danwahl/well-siting-meter/well-siting-meter.brd

## EAGLE design well-siting-meter.brd (2018-08-06)

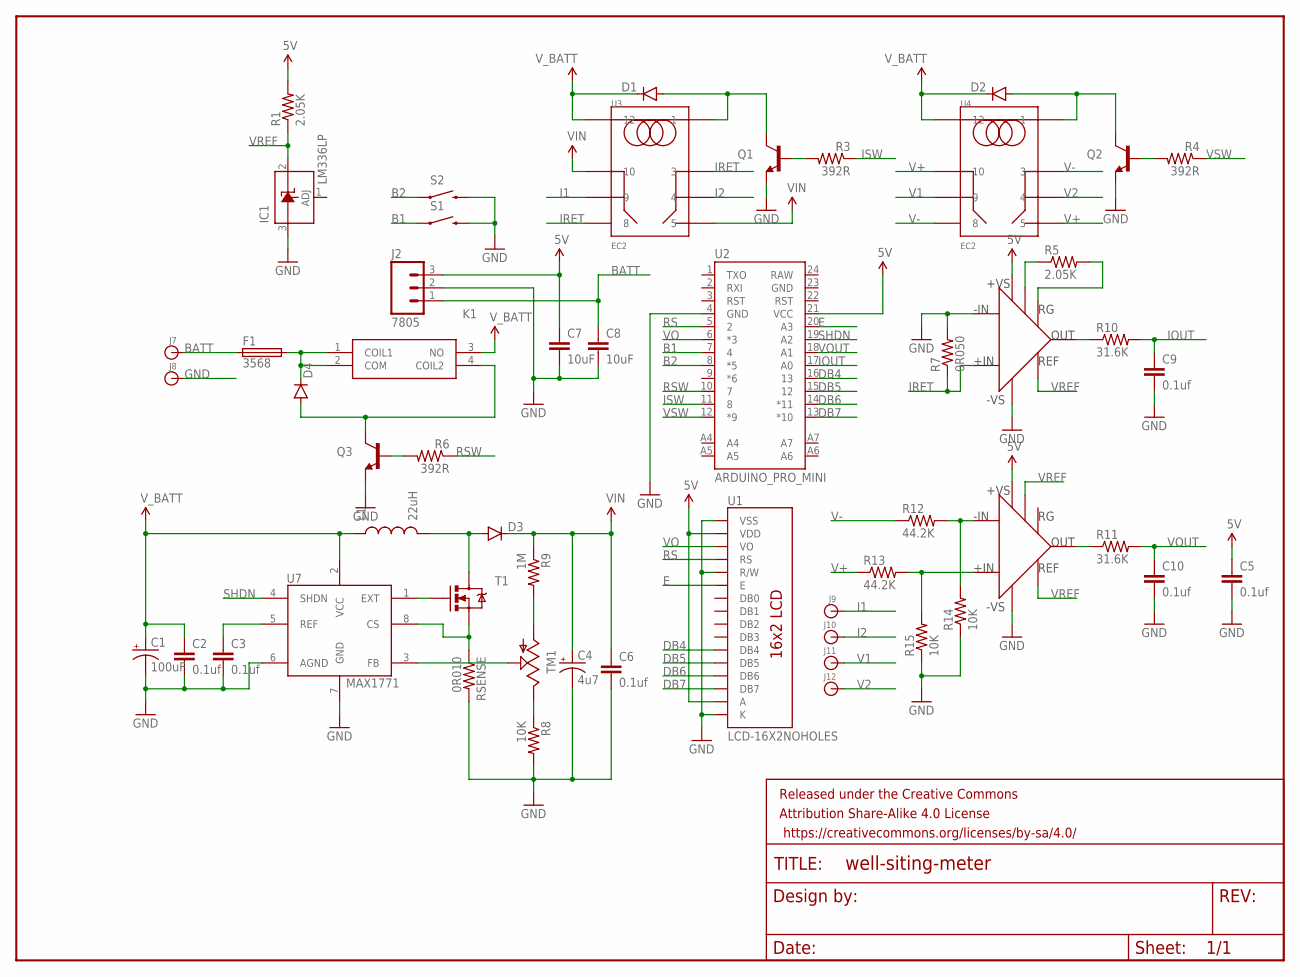
[picture p1: schematic well-siting-meter.sch]

Parts:
C1: 100uF; CPOL-RADIAL-1000UF-25V
C2, C3, C5, C6, C9, C10: 0.1uf; CAP-PTH-5MM
C4: 4u7; CPOL-RADIAL-1000UF-25V
C7, C8: 10uF; CAP-PTH-5MM
D1, D2, D3, D4: DIODEPTH; DIODE-1N4001
F1: 3568
FRAME1: FRAME-LETTER; CREATIVE_COMMONS
IC1: LM336LP; TO92
J2: 7805; 1X03
J7, J8, J9, J10, J11, J12: BANANA_CONN
K1: OJE-SH-105HM,000; OJ-SH-124LMH
L1: 22uH; 1415
Q1, Q2, Q3: TRANSISTOR_NPNTO92; TO-92
R1, R5: 2.05K; AXIAL-0.4
R3, R4, R6: 392R; AXIAL-0.4
R7: 0R050; AXIAL-0.6
R8, R14, R15: 10K; AXIAL-0.4
R9: 1M; AXIAL-0.4
R10, R11: 31.6K; AXIAL-0.4
R12, R13: 44.2K; AXIAL-0.4
RSENSE: 0R010; AXIAL-0.6
S1, S2: SWITCH-MOMENTARY-2PTH; TACTILE-PTH
T1: MOSFET-NCHANNELFQP30N06L; TO220V
TM1: TRIM3386; TRIM-3386
U1: LCD-16X2NOHOLES; LCD-16X2_NOHOLES
U2: ARDUINO_PRO_MINI
U3, U4: EC2
U5: AD623; DIP08
U6: AD629; DIP08
U7: MAX1771; DIP-08

Connections:
5V: C5.1, C7.1, J2.3, R1.P$2 (2), U1.2 (VDD), U1.15 (A), U2.21 (VCC), U5.7 (+VS), U6.7 (+VS)
B1: S1.1, U2.7 (4)
B2: S2.1, U2.8 (*5)
BATT: C8.1, F1.1, F1.2 (1), J2.1, J7.P$1
DB4: U1.11 (DB4), U2.16 (13)
DB5: U1.12 (DB5), U2.15 (12)
DB6: U1.13 (DB6), U2.14 (*11)
DB7: U1.14 (DB7), U2.13 (*10)
E: U1.6 (E), U2.20 (A3)
FUSE: D4.C, F1.3 (2), F1.4 (2), K1.1 (COIL1), K1.2 (COM)
GND: C1.2 (-), C2.2, C3.2, C4.2 (-), C5.2, C6.2, C7.2, C8.2, C9.2, C10.2, IC1.3 (A), J2.2, J8.P$1, Q1.1 (E), Q2.1 (E), Q3.1 (E), R7.P$2 (2), R8.P$2 (2), R14.P$1 (1), R15.P$1 (1), RSENSE.P$2 (2), S1.3 (2), S2.3 (2), U1.1 (VSS), U1.5 (R/W), U1.16 (K), U2.4 (GND), U5.2 (-IN), U5.4 (-VS), U6.4 (-VS), U7.6 (AGND), U7.7 (GND)
I1: J9.P$1, U3.9
I2: J10.P$1, U3.4
IOUT: C9.1, R10.P$2 (2), U2.17 (A0)
IRET: R7.P$1 (1), U3.3, U3.8, U5.3 (+IN)
ISW: R3.P$1 (1), U2.11 (8)
unnamed: D2.A, Q2.3 (C), U4.1
unnamed: Q2.2 (B), R4.P$2 (2)
unnamed: D1.A, Q1.3 (C), U3.1
unnamed: Q1.2 (B), R3.P$2 (2)
unnamed: R9.P$2 (2), TM1.3 (A)
unnamed: C3.1, U7.5 (REF)
unnamed: R8.P$1 (1), TM1.1 (E)
unnamed: D3.A, L1.P2 (2), T1.2 (D)
unnamed: T1.1 (G), U7.1 (EXT)
unnamed: RSENSE.P$1 (1), T1.3 (S), U7.8 (CS)
unnamed: R10.P$1 (1), U5.6 (OUT)
unnamed: R12.P$2 (2), R14.P$2 (2), U6.2 (-IN)
unnamed: R11.P$1 (1), U6.6 (OUT)
unnamed: TM1.2 (S), U7.3 (FB)
unnamed: R13.P$2 (2), R15.P$2 (2), U6.3 (+IN)
unnamed: D4.A, K1.4 (COIL2), Q3.3 (C)
unnamed: Q3.2 (B), R6.P$2 (2)
unnamed: R5.P$1 (1), U5.1 (-RG)
unnamed: R5.P$2 (2), U5.8 (+RG)
RS: U1.4 (RS), U2.5 (2)
RSW: R6.P$1 (1), U2.10 (7)
SHDN: U2.19 (A2), U7.4 (SHDN)
V1: J11.P$1, U4.9
V2: J12.P$1, U4.4
V+: R13.P$1 (1), U4.5, U4.10
V-: R12.P$1 (1), U4.3, U4.8
VIN: C4.1 (+), C6.1, D3.C, R9.P$1 (1), U3.5, U3.10
VO: U1.3 (VO), U2.6 (*3)
VOUT: C10.1, R11.P$2 (2), U2.18 (A1)
VREF: IC1.2 (C), R1.P$1 (1), U5.5 (REF), U6.1 (-RG), U6.5 (REF)
VSW: R4.P$1 (1), U2.12 (*9)
V_BATT: C1.1 (+), C2.1, D1.C, D2.C, K1.3 (NO), L1.P1 (1), U3.12, U4.12, U7.2 (VCC)

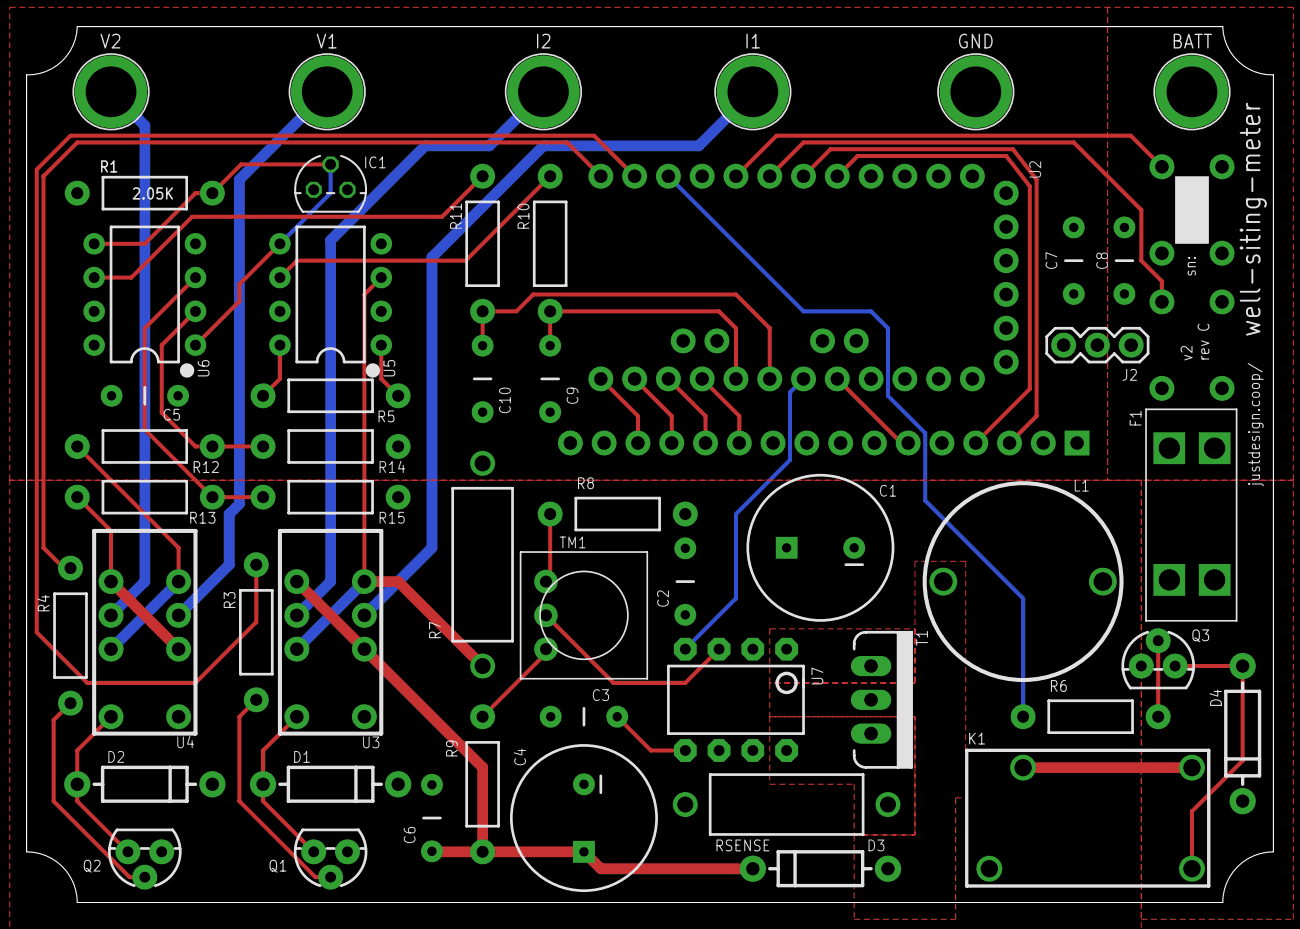
[picture p2: board well-siting-meter.brd from above]

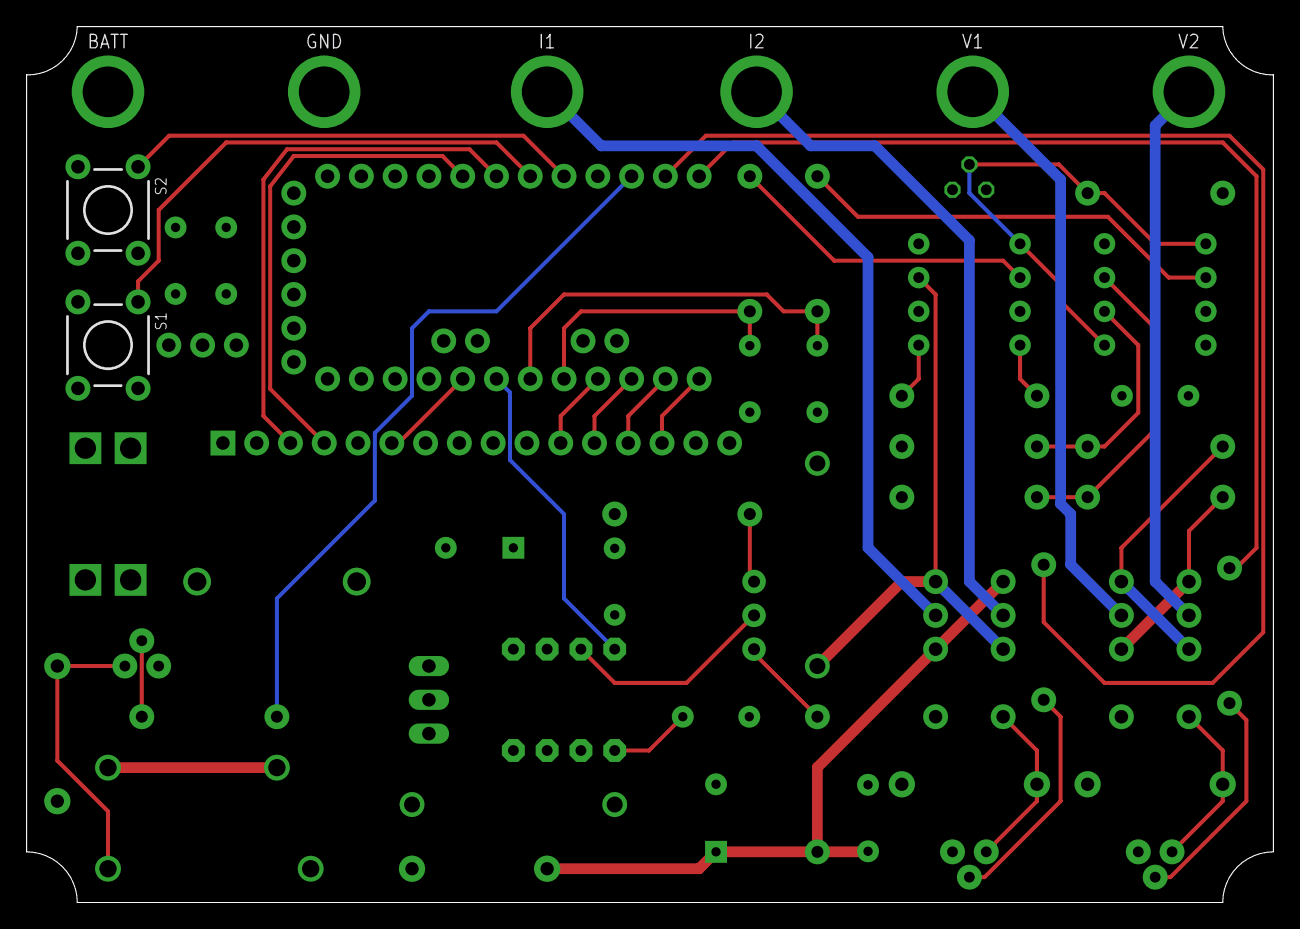
[picture p3: board well-siting-meter.brd from below]

Board: 2 copper layers, 93.8 x 65.9 mm, 55 parts (3 on the bottom side), 48 nets.
