danwahl/well-siting-meter/(commit log)

2017-06-04 initial commit (schematic)
    [well-siting-meter.brd, well-siting-meter.sch]
2018-04-14 boost circuit, lcd screen, starting board layout
    [well-siting-meter.brd, well-siting-meter.sch]
2018-04-15 "finished" design, but need to update boot circuity for > 10W max
    [well-siting-meter.brd, well-siting-meter.sch]
2018-04-15 added boost circuit
    [well-siting-meter.brd, well-siting-meter.sch]
2018-04-15 adding part numbers
    [well-siting-meter.brd, well-siting-meter.sch]
2018-04-16 updated inductor, adding part numbers
    [well-siting-meter.brd, well-siting-meter.sch]
2018-04-16 fixed board outline, added remaining part numbers
    [well-siting-meter.brd, well-siting-meter.sch]
2018-04-16 rearranged a few polygons
    [well-siting-meter.brd]
2018-04-17 prep for mfg
    [well-siting-meter.brd, well-siting-meter.sch]
2018-04-17 adding optional 2nd inductor, more mfg prep
    [well-siting-meter.brd, well-siting-meter.sch]
2018-04-17 rev - mfg files
    [well-siting-meter-bom.csv, well-siting-meter.brd, well-siting-meter.sch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]
2018-04-23 fixed cap packages (5mm)
    [well-siting-meter.brd, well-siting-meter.sch]
2018-04-27 adding arduino project, starting rev A fixes
    [well-siting-meter.sch]
2018-04-29 updating arduino code
2018-05-02 rev A updates, arduino testing
    [well-siting-meter.brd, well-siting-meter.sch]
2018-05-02 rev A, bom updates
    [well-siting-meter-bom.csv, well-siting-meter.brd, well-siting-meter.sch]
2018-05-06 rev A manufacturing
    [well-siting-meter-bom.csv, well-siting-meter.brd, well-siting-meter.sch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]
2018-06-11 start of rev B updates (added relay, AD629, fuse)
    [well-siting-meter.brd, well-siting-meter.sch]
2018-06-30 rev B updates (AD629, fuse holder, power relay)
    [well-siting-meter.brd, well-siting-meter.sch]
2018-06-30 adding ic1 for 2.5 vref
    [well-siting-meter.brd, well-siting-meter.sch]
2018-07-02 rev B build
    [well-siting-meter-bom.csv, well-siting-meter.brd, well-siting-meter.sch]
2018-08-05 updated arduino code for rsw
2018-08-06 rev C initial commit, modifying vref and voltage input resistors
    [voltage-test.sch, well-siting-meter.brd, well-siting-meter.sch]
